AhmWael/The_Pythons_Fast_Line_Follower/Hardware/Mechanical/Base_Plate.STEP

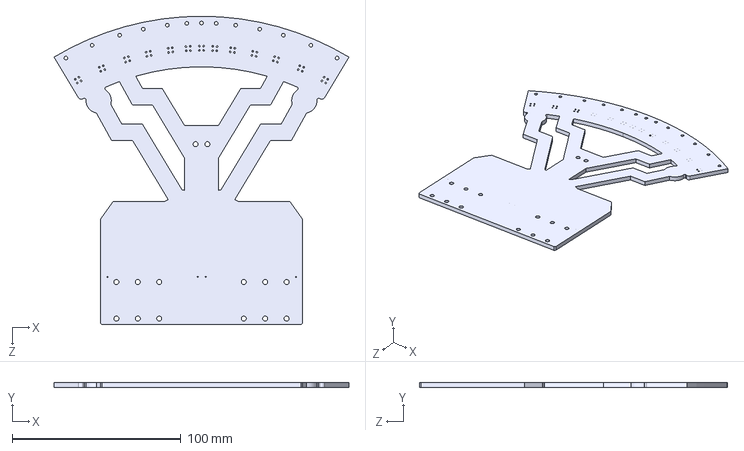
[picture p1: CAD file, 2024-09-30]
Hardware/Mechanical/Base_Plate.STEP
175.0 x 3.00 x 183.0 mm
