AhmWael/The_Pythons_Fast_Line_Follower/Hardware/Mechanical/Camera_Holder.STEP

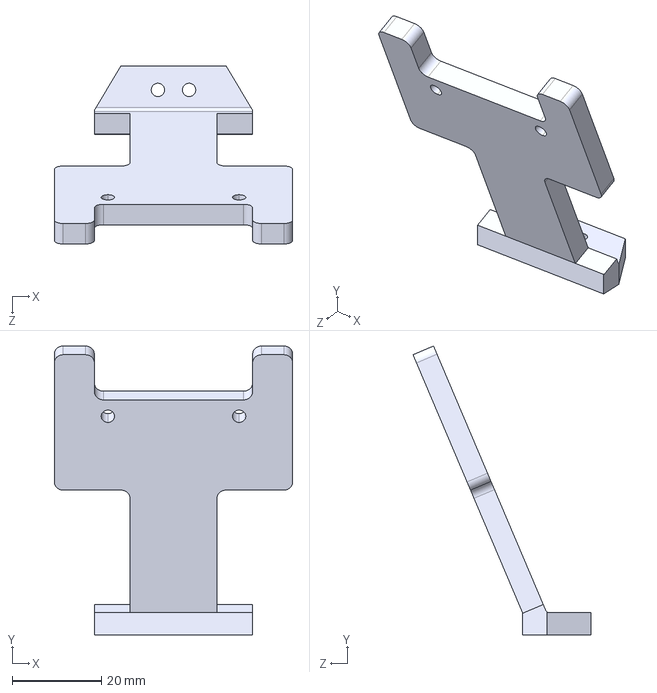
[picture p2: CAD file, 2024-09-30]
Hardware/Mechanical/Camera_Holder.STEP
53.5 x 64.8 x 39.9 mm
