AhmWael/The_Pythons_Fast_Line_Follower/Hardware/Electrical/PCB_5.brd

## EAGLE design Hardware/Electrical/PCB_5.brd (2024-09-30)

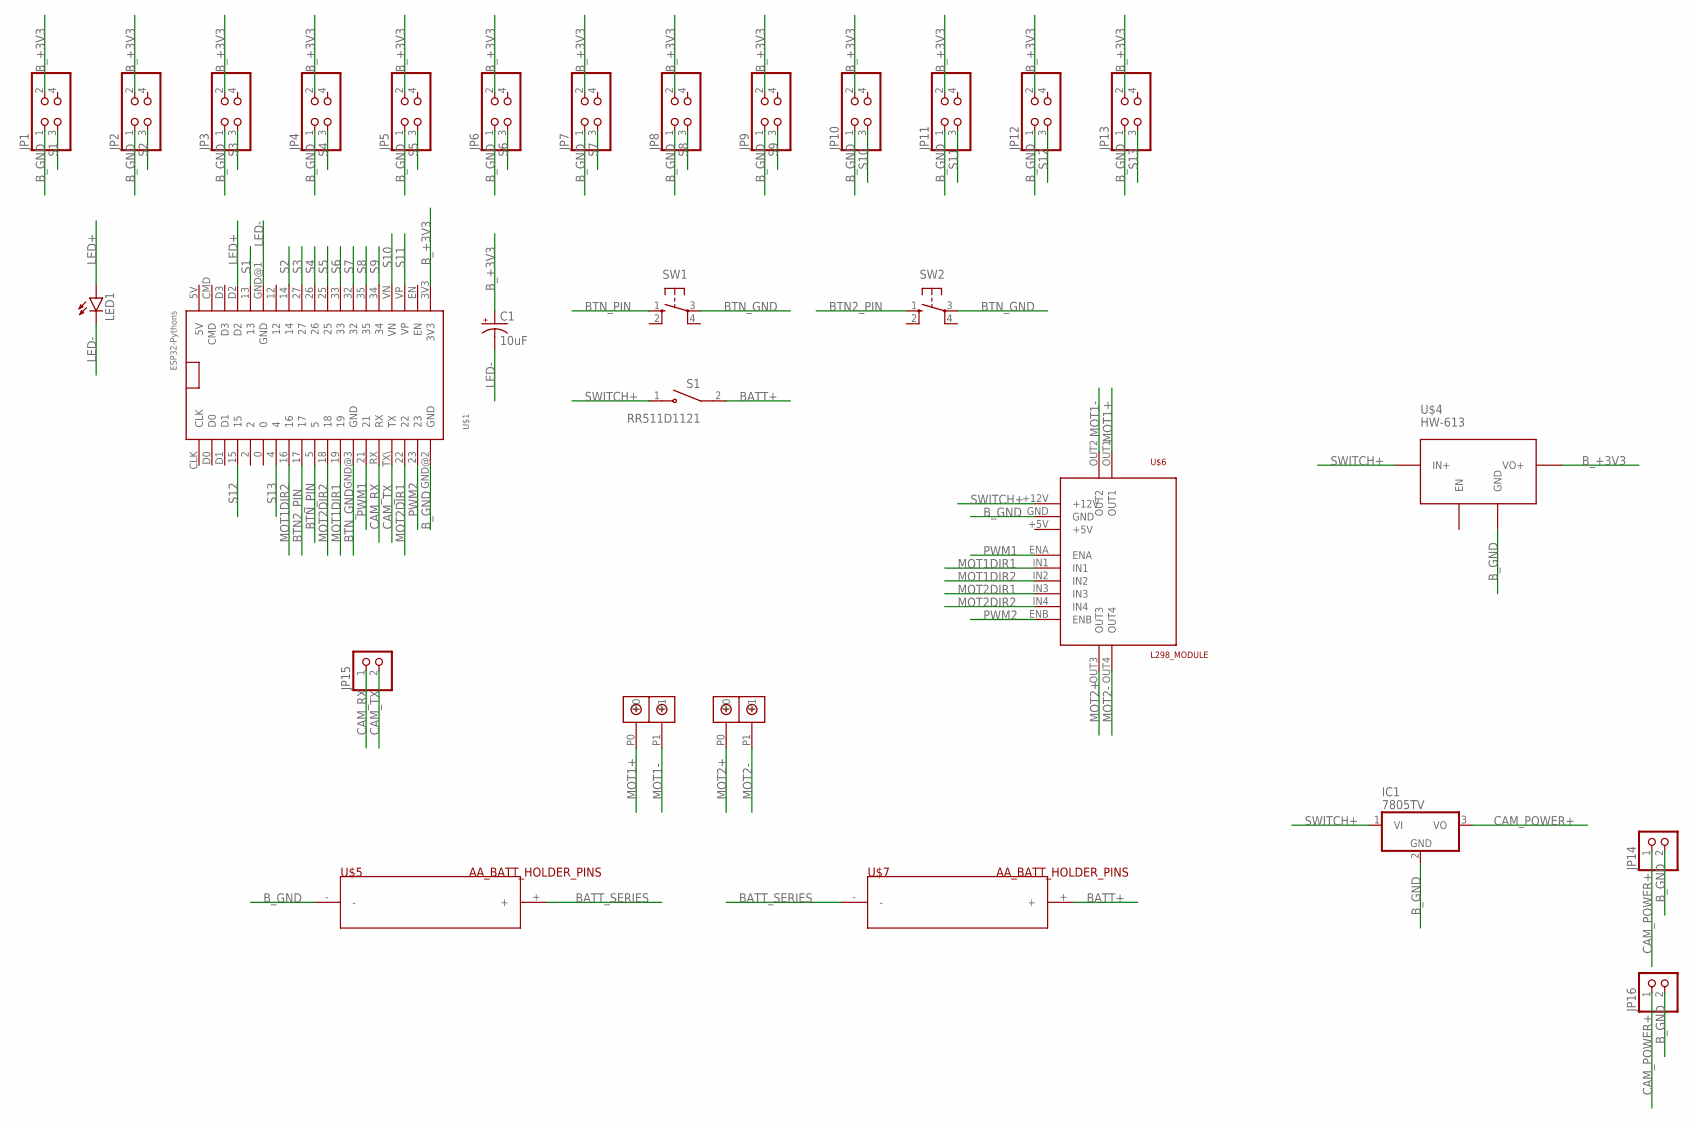
[picture p3: schematic PCB_5.sch]

Parts:
C1: 10uF; CPOL-RADIAL-2.5MM-5MM
IC1: 7805TV; TO220V
JP1, JP2, JP3, JP4, JP5, JP6, JP7, JP8, JP9, JP10, JP11, JP12, JP13: PINHD-2X2; 2X02
JP14, JP15, JP16: PINHD-1X2; 1X02
LED1: LED5MM
S1: RR511D1121; E-SWITCH_RR511D1121
SW1, SW2: 10-XX; B3F-10XX
U$1: ESP32DEVKITV1; ESP32-DEVKITV1
U$2, U$3: DBCONN-1X2
U$4: HW-613
U$5, U$7: AA_BATT_HOLDER_PINS
U$6: L298_MODULE

Connections:
BATT+: S1.2 (COM), U$7.+
BATT_SERIES: U$5.+, U$7.-
BTN2_PIN: SW2.1 (S), U$1.17
BTN_GND: SW1.3, SW2.3, U$1.GND@3 (GND)
BTN_PIN: SW1.1 (S), U$1.5
B_+3V3: C1.1 (+), JP1.2, JP2.2, JP3.2, JP4.2, JP5.2, JP6.2, JP7.2, JP8.2, JP9.2, JP10.2, JP11.2, JP12.2, JP13.2, U$1.3V3, U$4.VO+
B_GND: IC1.2 (GND), JP1.1, JP2.1, JP3.1, JP4.1, JP5.1, JP6.1, JP7.1, JP8.1, JP9.1, JP10.1, JP11.1, JP12.1, JP13.1, JP14.2, JP16.2, U$1.GND@2 (GND), U$4.GND, U$5.-, U$6.GND
CAM_POWER+: IC1.3 (VO), JP14.1, JP16.1
CAM_RX: JP15.1, U$1.RX
CAM_TX: JP15.2, U$1.TX\ (TX)
LED+: LED1.A, U$1.D2
LED-: C1.2 (-), LED1.K (C), U$1.GND@1 (GND)
MOT1+: U$2.P0, U$6.OUT1
MOT1-: U$2.P1, U$6.OUT2
MOT1DIR1: U$1.19, U$6.IN1
MOT1DIR2: U$1.16, U$6.IN2
MOT2+: U$3.P0, U$6.OUT3
MOT2-: U$3.P1, U$6.OUT4
MOT2DIR1: U$1.22, U$6.IN3
MOT2DIR2: U$1.18, U$6.IN4
PWM1: U$1.21, U$6.ENA
PWM2: U$1.23, U$6.ENB
S1: JP1.3, U$1.13
S2: JP2.3, U$1.14
S3: JP3.3, U$1.27
S4: JP4.3, U$1.26
S5: JP5.3, U$1.25
S6: JP6.3, U$1.33
S7: JP7.3, U$1.32
S8: JP8.3, U$1.35
S9: JP9.3, U$1.34
S10: JP10.3, U$1.VN
S11: JP11.3, U$1.VP
S12: JP12.3, U$1.15
S13: JP13.3, U$1.4
SWITCH+: IC1.1 (VI), S1.1 (NO), U$4.IN+, U$6.+12V

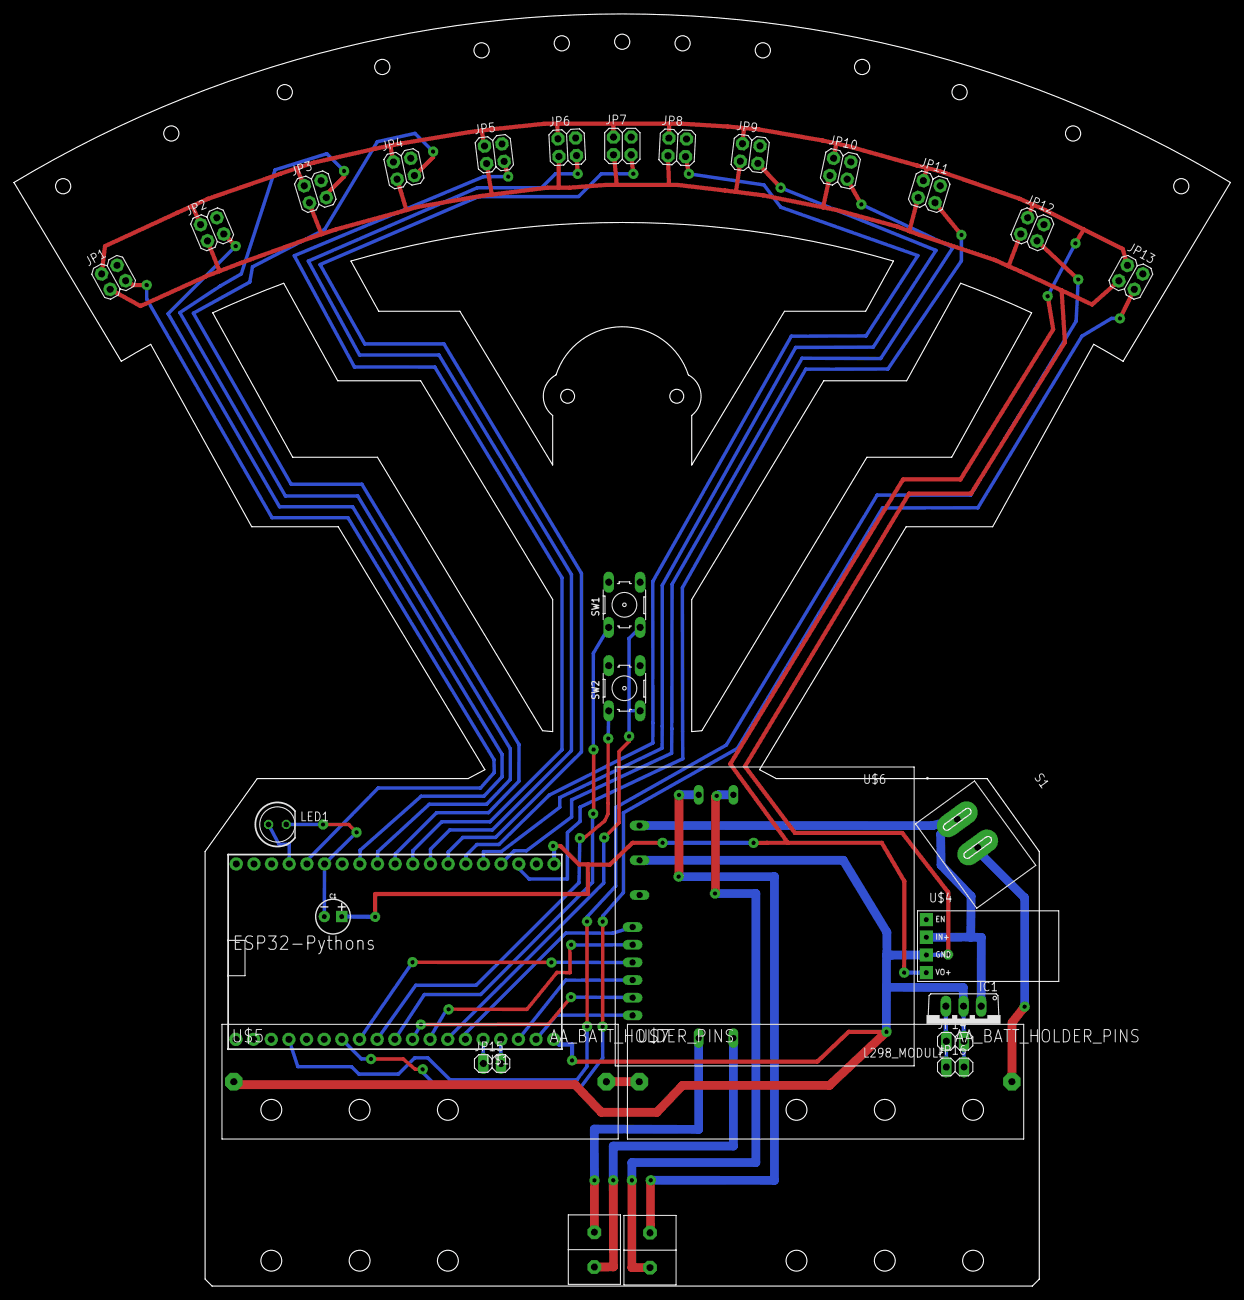
[picture p4: board PCB_5.brd from above]

Board: 2 copper layers, 175.0 x 183.0 mm, 29 parts (0 on the bottom side), 36 nets.
