AhmWael/The_Pythons_Fast_Line_Follower/Software/The_Pythons_Fast_Line_Follower_Code_Camera/PID_Functions.ino

/***** PID calculation function *****/
float calculatePID(long currentPosition) {
  long error = currentPosition - 0; // Error is the difference from the setpoint (0)
  integral += error; // Accumulate the error for the integral term
  float derivative = error - lastError; // Calculate the derivative term
#if defined(debug) && defined(debugPID)
  Serial.printf("Error: %ld\n", error);
#endif
  float control = (Kp * error) + (Ki * integral) + (Kd * derivative);

  lastError = error;

  return control;
}
