AhmWael/The_Pythons_Fast_Line_Follower/(commit log)

2024-08-21 Added PCB Design 1
    [Design_1.brd, Design_1.sch]
2024-08-29 Added latest hardware designs
    [Base_Plate.STEP, PCB_1.brd, PCB_1.sch]
2024-08-30 Added ESP32 Code
2024-08-31 Added Line Sensor Calibration
    - Added map function to map each sensor reading to a range of 0-1000
    - Added Calibration function to get minimum and maximum readings of sensors from each sensor
2024-08-31 Added button to start calibration
2024-09-01 Fixed some bugs in sensor read function and calibration
    [Sensor_Read_Functions.ino, The_Pythons_Fast_Line_Follower_Code.ino]
2024-09-02 first test sh8al
    removed last 2 corner sensors
    edited base speed
    editied kp value
2024-09-05 Before Changing PID Function
2024-09-10 Added backward & stop functionality and auto calibration
2024-09-12 Updated hardware files
    [Base_Plate.STEP, PCB_1.brd, PCB_4.brd, PCB_4.sch]
2024-09-13 Changed motor pins & fixed stop function
    [Movement_Functions.ino, The_Pythons_Fast_Line_Follower_Code_Weights.ino]
2024-09-16 Added Separate Arduino Camera Code + Python code
    Camera guiding robot on curves and straight lines
2024-09-17 Bluetooth + Camera updates
    Updated Bluetooth app to add camera parameters control.
    Updated Arduino code with camera to receive the arguments from the bluetooth app
    Updated Camera python code
    Added a separate code for line tracking with camera only
2024-09-17 added last_case in camera+ stop before slow down
2024-09-19 Added calibration speed variable & fixed values for backward and stop
    [Movement_Functions.ino, Sensor_Read_Functions.ino, The_Pythons_Fast_Line_Follower_Code_Camera.ino]
2024-09-22 Added adjust backspeed with sensor line position
2024-09-25 Added Start Button + Camera Code Enhancements
    - Added the event of pushbutton to start at speed of 225 ( to be edited later)
    - Camera Line following break when last 2 IRs detected black
    - Added constraints for upper region
    - Added middle region position when upper region and lower region not detected
2024-09-26 Enhanced Camera Code
    Using the first and last regions only for guidance
2024-09-27 Camera Code edit
    -Changed crop and region values
    -Line deflection depends on the top region only
2024-09-30 Updated hardware
    [Base_Plate.STEP, Camera_Holder.STEP, PCB_5.brd, PCB_5.sch]
2024-10-01 Minor modification in values of main code and camera python script
    -Changed threshold, contrast and brightness for camera
    -Increased delay for curves in main code
2024-10-01 Updated Bluetooth App
    Edited Bluetooth device address for new ESP32
